JuperTronic/Jupertronic_Super_Skeeter_Sequence_Synth/24 segment pot big 7 2 inch.jpg

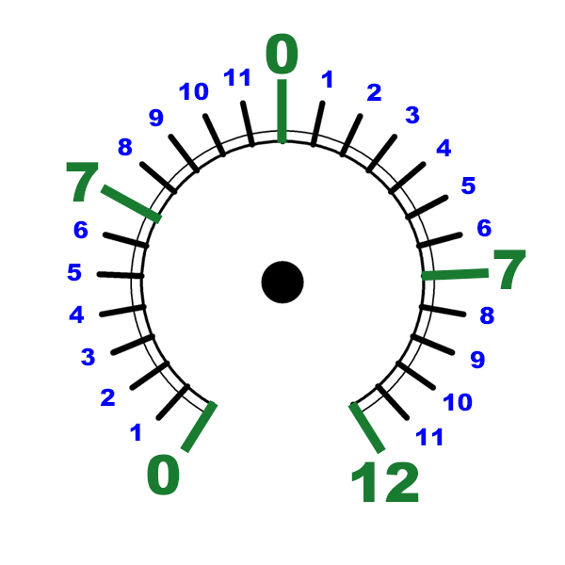
24 segment pot big 7 2 inch.jpg
