JuperTronic/Jupertronic_Super_Skeeter_Sequence_Synth/MIDI Schematics/Arduino Midi In_NotesandVolts.jpg

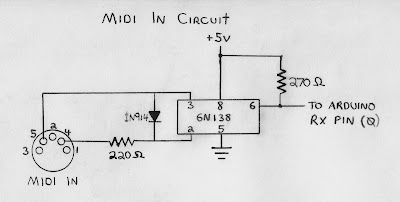
MIDI Schematics/Arduino Midi In_NotesandVolts.jpg
