JuperTronic/Jupertronic_Super_Skeeter_Sequence_Synth/MIDI Schematics/MIDI_out_MIDIdotOrg.png

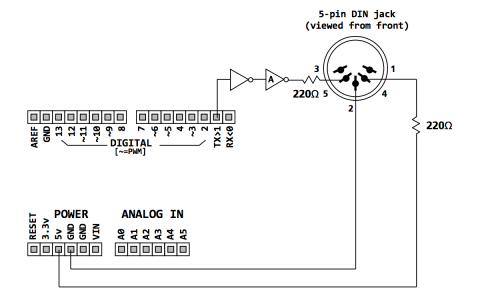
MIDI Schematics/MIDI_out_MIDIdotOrg.png
