JuperTronic/Jupertronic_Super_Skeeter_Sequence_Synth/Circuit Schematics/Skeeter v1_schem.pdf

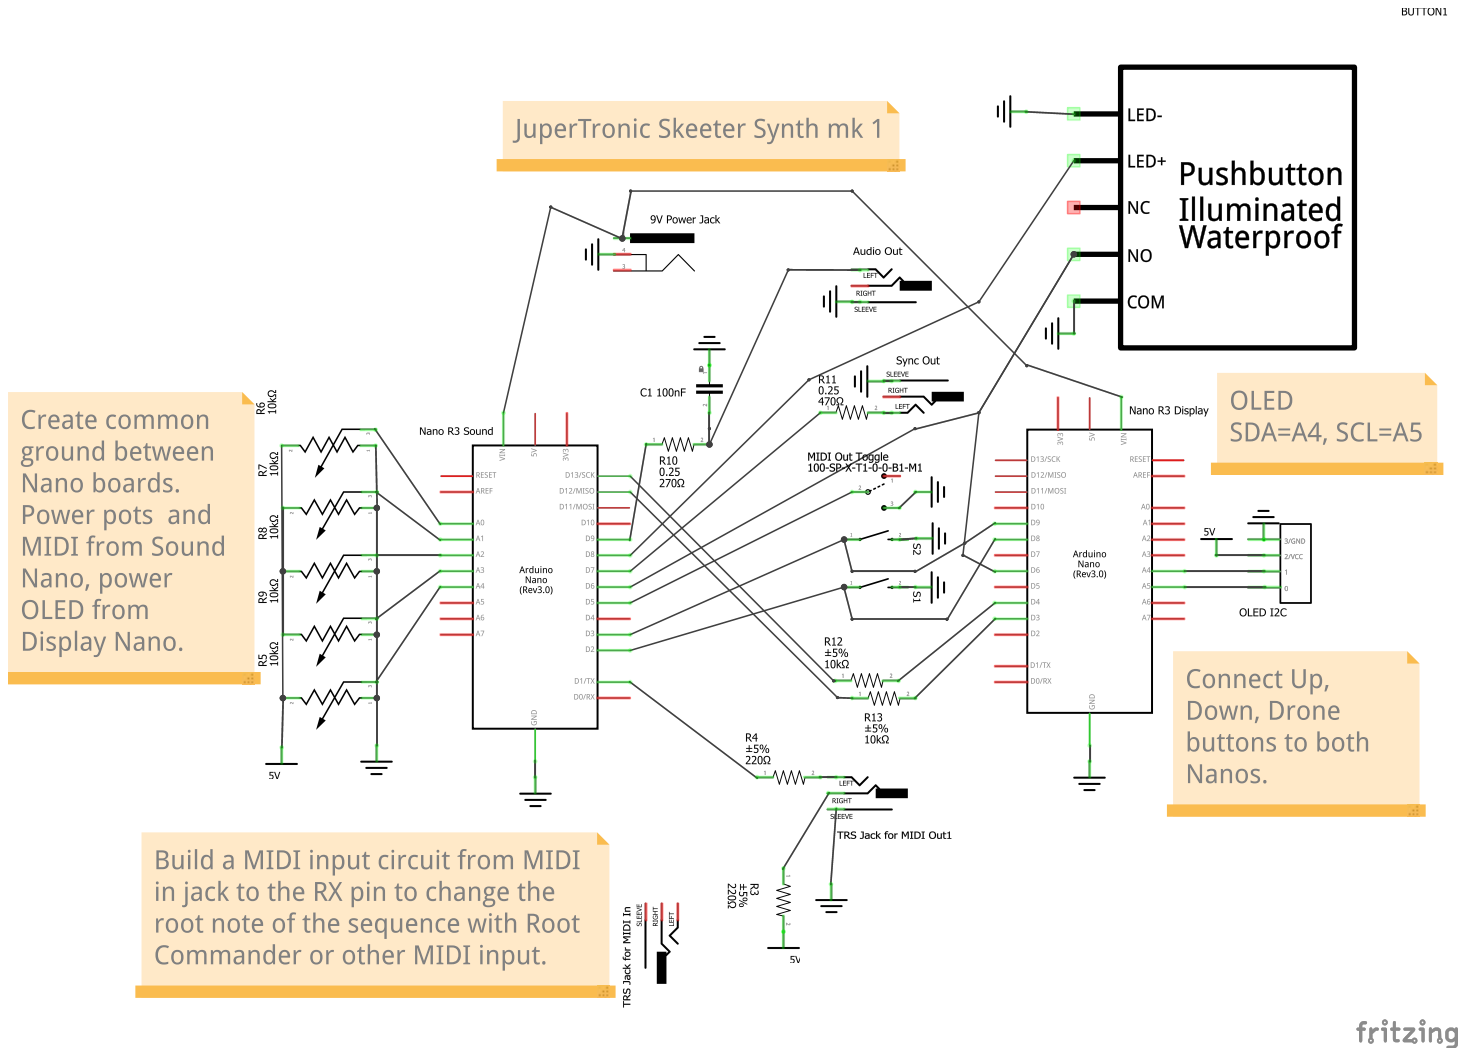
[picture p4: page 1]
