JuperTronic/Jupertronic_Super_Skeeter_Sequence_Synth/(commit log)

2022-04-14 Arduino sketches
2022-04-14 MIDI in and out circuits
2022-04-28 Updated MIDI out pitch control
2023-04-22 Add files via upload
    Rough schematics
